4ms/pcb-SCMv3/p5/pcba/Quotation (scmplus-faceplate-v1.0).pdf

Customer:
ATTN: Dan
15th.Jul.2022
P/N: | scmplus-faceplate-v1.0
Layer counts: | 2L
Material: | FR4 1.6mm
Finished copper: | 1oz
Surface finished: | HASL-LF
Unit size: | 60.6*128.5mm
Panel size: | /
Solder Mask color: | Black
Legend color: | White
Min hole size: | 2.92mm
Hole quantity: | 92
Min Track /Gap: | copper
Min space from hole to line | /

Other info:

Notes: | pls confirm the data in red color
Quantity: | | 200pcs
Unit price( USD /PCS): | | $2.18
Tooling charge and Flying test cost : | | $200.00
Freigth cost (USD) : | | /
Total amount(USD): | | $636.00
Delivery time:
1.56sqm
Note:
1. This quotation is based on the above specification. Any change to this specification will alter the price.
2. The lead time is only for production, not including time on engineering queries or shipment
3. We will charge the test cost if the repeat order will not reach our the Min charge.

# Posin Electronics Limited

Address :B-709,Dahong High-tech Park,No.28 Beiting Road Shajing Street,Baoan District, Shenzhen City TEL: +86-755-86372522 FAX:+86-755-86372119 EMAIL:sales3@posinpcb.com

From: Posin Electronics Limited

# Quotation

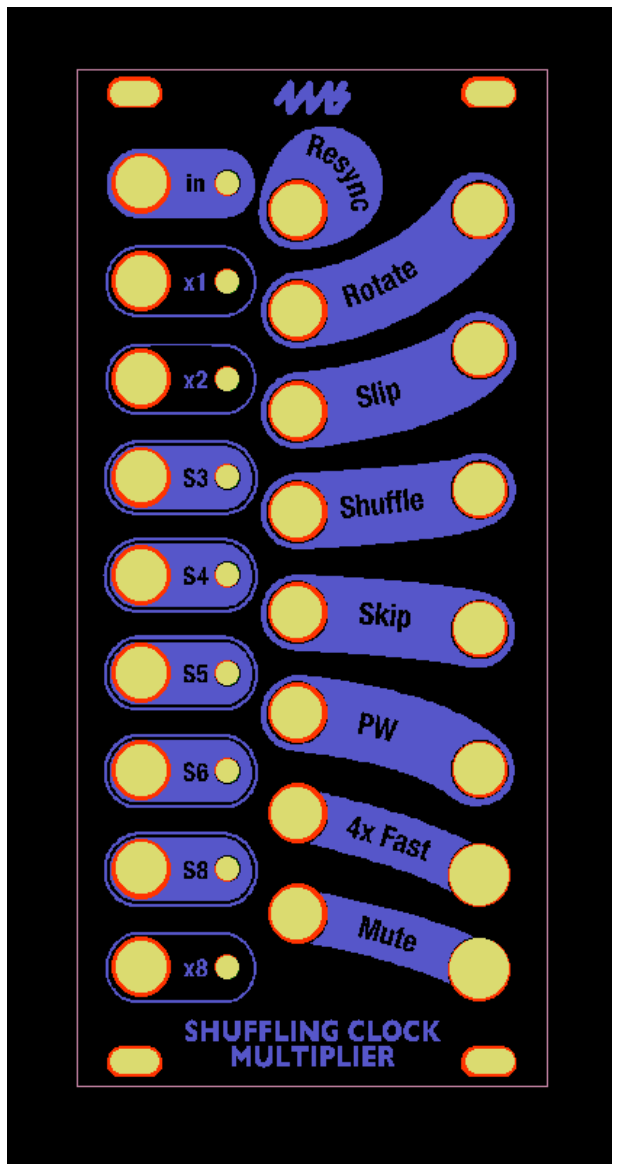
[picture p1: figure]
1.min. 25um copper in PTH
