4ms/pcb-SCMv3/faceplate-p1/artwork sources/2000ppi/silk.png

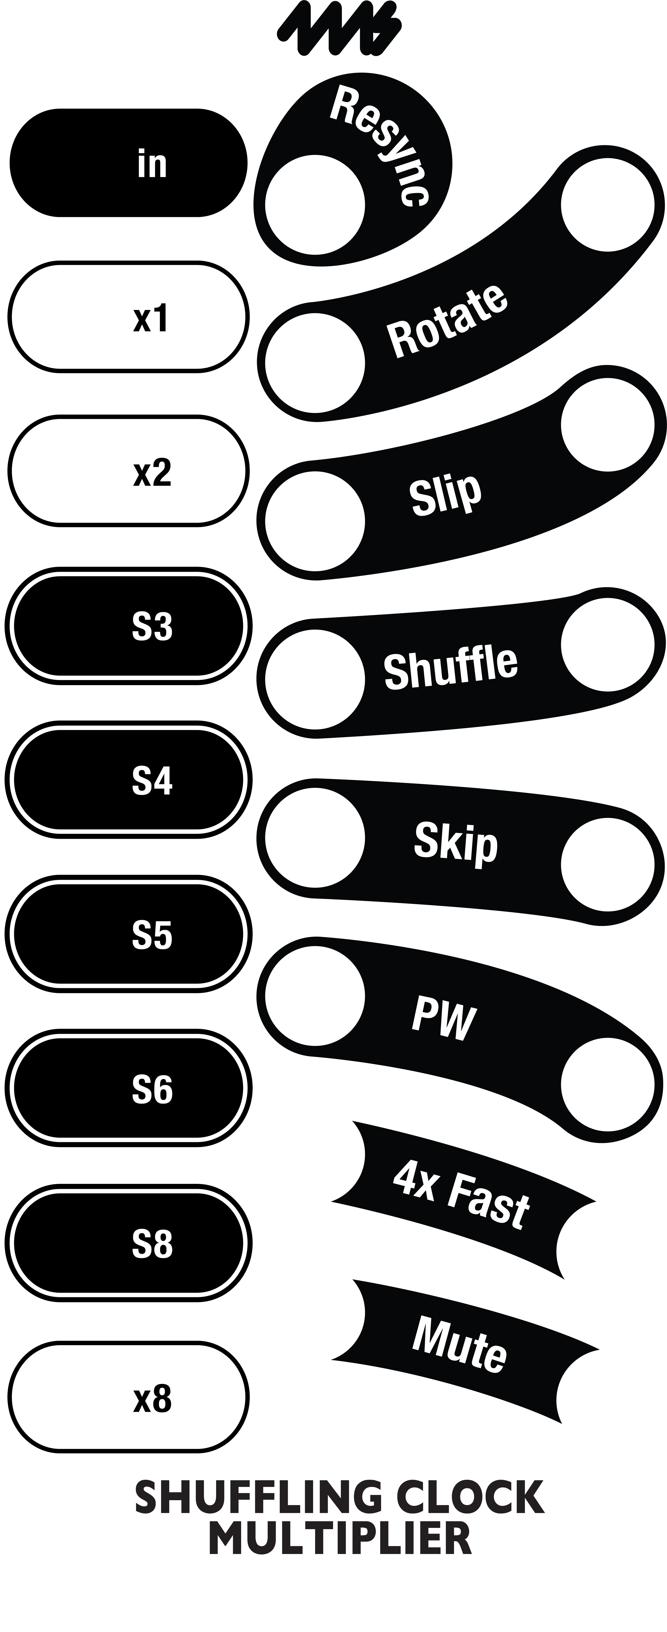
faceplate-p1/artwork sources/2000ppi/silk.png
