4ms/pcb-SCMv3/faceplate-p1/board-lineup.jpg

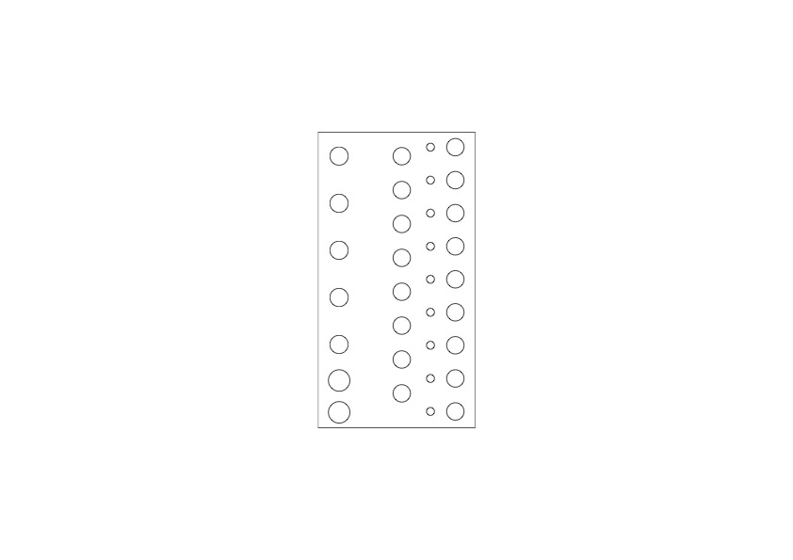
faceplate-p1/board-lineup.jpg
