4ms/pcb-SCMv3/p5/pcba/SCMplus-bom_BX2040396V1-EQ.xlsx

Sheet: EQs
顾客型号(Customer P/N)： |  | scmplus-v1.0 | Posin Electronics Limited
博鑫型号（Posin Lot No）： |  | BX2040396V1
顾客代码(Customer Code)： |  | 204
编写人(Made by)： |  | 刘韶华
联系电话（Telephone） |  | 0755-86372522
编写日期时间(Date&Time)： |  | 2022-07-20 | Address :B-709,Dahong High-tech Park,No.28 Beiting Road Shajing Street,Baoan District, Shenzhen China
博鑫工程师问题列表(EQs from Posin) |  |  |  |  |  | 答复人（Answer by)：
序号 No. | 问题描述 Problem Description |  |  | 博鑫建议 Posin Recommendation | 附件 Attachments | 客户回复 customer's answer
1 | Pls see 1.jpg. Item 16 on the BOM, P/N: RC0603FR-0710KL, desginator: R3, R7, R36. The value of the resistance is 10k, but description column has two vaules 470R and 10k. Pls confirm which value is correct. |  |  |  | 1.jpg | pls reply here | Correct value is 10k
2 | Pls see 2.jpg. Item 21 on the BOM, P/N: RC0603FR-0710KL, desginator R16, R44, R45, R47, R48, R50. The value of the resistance is 10K, but description column has two values 100K and 10K, pls confirm which value is correct. |  |  |  | 2.jpg | pls reply here | Correct value is 10k
3 | Pls see 3.jpg. Item 23 on the BOM, P/N: RC0603FR-0710KL, desginator R22, the value of the resistance is 10K, but the description column has two values 4.7K and 10K. Pls confirm which value is correct. |  |  |  | 3.jpg | pls reply here | Correct value is 10k
4 | Pls see 4,jpg. Item 24 on the BOM, P/N: RC0603FR-0715KL, desginator R30, R37, R39. The value of the resistance is 15K, but the description column has two values 100k and 15K, pls confirm which value is correct. |  |  |  | 4.jpg | pls reply here | Correct value is 15k
5 | Pls see 5.jpg. Item 26 on the BOM, P/N: RC0603FR-0747KL, desginator R40. The value of the resistance is 47K, but the description column shows the value is 470K. Pls confirm which value is correct. |  |  |  | 5.jpg | pls reply here | Correct part number is RC0603FR-07470KL (47k)
6 | Pls see 6.jpg. Item 28 on the BOM, P/N: RC0603FR-071KL, desginator R43, R46, R49. The value of the resistance is 1K, but the description column has tao values 100R and 1K, pls confirm which value is correct. |  |  |  | 6.jpg | pls reply here | Correct value is 1k
7 | Pls see 7.jpg. Item 9 on the BOM, P/N: 1-0601FBV0T, desginator J1. But we didn't find the silk screen J1 on the PCB. Pls mark J1 position on the PCB picture on 7.jpg |  |  |  | 7.jpg | pls reply here | See picture
8 |  |  |  |  | 8.jpg
9 |  |  |  |  | 9.jpg
10 |  |  |  |  | 10.jpg
11 |  |  |  |  | 11.jpg
12 |  |  |  |  | 12.jpg
13 |  |  |  |  | 13.jpg
14 |  |  |  |  | 14.jpg
15 |  |  |  |  | 15.jpg
16 |  |  |  |  | 16.jpg
17 |  |  |  |  | 17.jpg

Sheet: 1.jpg
返回（Return） EQs

Sheet: 2.jpg
返回（Return） EQs

Sheet: 3.jpg
返回（Return） EQs

Sheet: 4.jpg
返回（Return） EQs

Sheet: 5.jpg
返回（Return） EQs

Sheet: 6.jpg
返回（Return） EQs

Sheet: 7.jpg
返回（Return） EQs

Sheet: 8.jpg
返回（Return） EQs

Sheet: 9.jpg
返回（Return） EQs

Sheet: 10.jpg
返回（Return） EQs

Sheet: 11.JPG
返回（Return） EQs

Sheet: 12.jpg
返回（Return） EQs

Sheet: 13.jpg
返回（Return） EQs

Sheet: 14.jpg
返回（Return） EQs

Sheet: 15.jpg
返回（Return） EQs

Sheet: 16.jpg
返回（Return） EQs

Sheet: 17.jpg
返回（Return） EQs
