4ms/pcb-SCMv3/faceplate-p2/SCMv3-B_Silkscreen.pdf

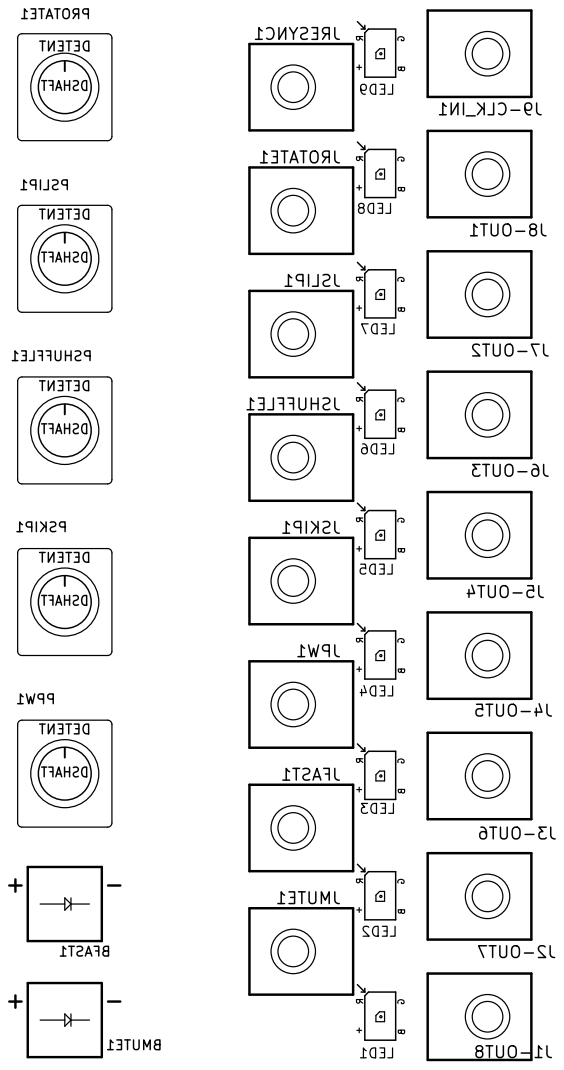
[picture p4: page 1]
