4ms/pcb-SCMv3/faceplate-p1/board-lineup.pdf

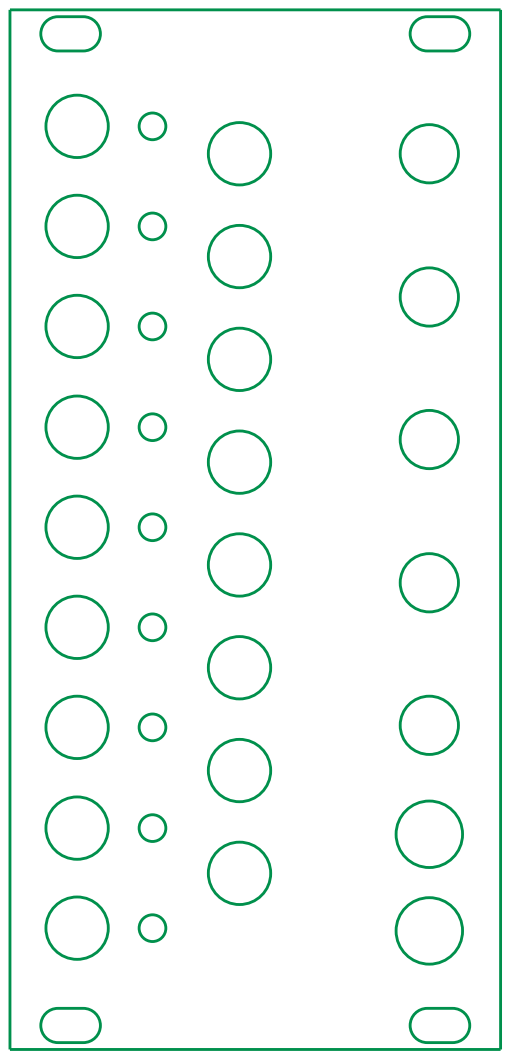
[picture p5: page 1]
