4ms/pcb-SCMv3/faceplate-p1/export.pdf

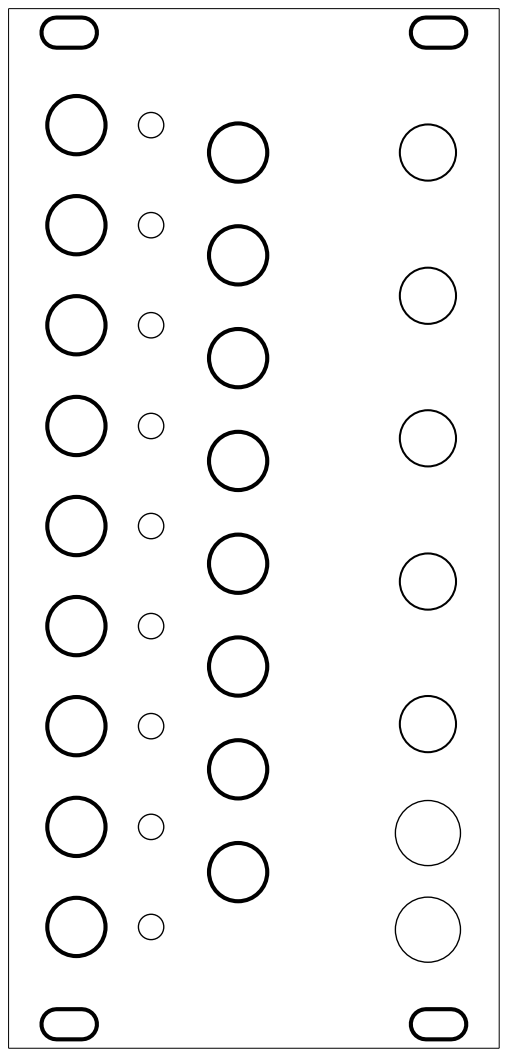
[picture p6: page 1]
