4ms/pcb-SCMv3/p3/cubemx/scmv3-f030k/scmv3-f030k.ioc

Mcu.UserName=STM32F030K6Tx
PA0.Signal=GPIO_Output
PA1.Signal=GPIO_Output
PA12.Signal=GPIO_Input
PA13.Signal=SYS_SWDIO
PA14.Signal=SYS_SWCLK
PA15.Signal=GPIO_Input
PA2.Signal=ADC_IN2
PA3.Signal=ADC_IN3
PA4.Signal=GPIO_Output
PA5.Signal=GPIO_Output
PA6.Signal=GPIO_Output
PA7.Signal=ADC_IN7
PB0.Signal=ADC_IN8
PB1.Signal=ADC_IN9
PB3.Signal=GPIO_Input
PB4.Signal=GPIO_Input
PB5.Signal=GPIO_Output
PB6.Signal=GPIO_Output
PB7.Signal=GPIO_Output
PF0-OSC_IN.Signal=RCC_OSC_IN
PF1-OSC_OUT.Signal=RCC_OSC_OUT
