4ms/pcb-SCMv3/(commit log)

2021-06-21 Initial commit: combined SCM + SCMBO files
    [SCMv3.kicad_pcb, SCMv3.kicad_sch]
2021-06-21 Added original SCM/SCMBO schematics converted to Kicad5.99
    [SCMBO.kicad_sch, clocker-12b.kicad_sch, clocker-12b_1.kicad_sch, clocker-12b_2.kicad_sch]
2021-06-22 combo schematic as of 6/21/21
    [SCMv3.kicad_sch]
2021-06-23 6/21 scm schematic
    [SCMv3.kicad_sch]
2021-06-23 SCMV3 SCHEMATIC 6/21
    [SCMv3.kicad_sch]
2021-06-25 SCM combo schematic 6/24
    [SCMv3.kicad_sch]
2021-06-25 6/25 SCM SCHEM
    [SCMv3.kicad_sch]
2021-06-25 6/25 SCM SCHEMATIC
    [SCMv3.kicad_sch]
2021-06-25 6/25 SCM
    [SCMv3.kicad_sch]
2021-06-28 SCHEM + PCB 6/
    [SCMv3.kicad_pcb, SCMv3.kicad_sch]
2021-06-30 PCB + SCHEM 6/30
    [SCMv3.kicad_pcb, SCMv3.kicad_sch]
2021-07-02 PCB +SCHEM 7/02
    [SCMv3.kicad_pcb, SCMv3.kicad_sch]
2021-07-05 SCM PCB+SCHEM 7/05
    [SCMv3.kicad_pcb]
2021-07-07 Fixes/tweaks to sch+pcb:
    -Changed PCB form 16-layer to 2-layer board.
    -RESET net was attached to +5V, moved it to _RESET/PC6 pin 29 of U1
    -Renamed net UC_IN to UC_LED_IN (it only drives the IN LED, nothing else)
    [SCMv3.kicad_pcb, SCMv3.kicad_sch]
2021-07-07 Moved XTAL caps (C4, C5) GND trace to go directly to uc (U1)
    [SCMv3.kicad_pcb]
2021-07-07 Removed all duplicate Vias. Project ignores silk overlap DRC errors
    [SCMv3.kicad_pcb]
2021-08-14 Added faceplate
    [SCMv3-faceplate-B_Cu.gbl, SCMv3-faceplate-B_Mask.gbs, SCMv3-faceplate-Edge_Cuts.gm1, SCMv3-faceplate-F_Cu.gtl, SCMv3-faceplate-F_Mask.gts, SCMv3-faceplate-F_Silkscreen.gto, SCMv3-faceplate-drl_map.gbr, SCMv3-faceplate-job.gbrjob]
2021-08-16 SCM v3 updates
    *added missing trace for buttons
    *moved trip pot
    *flipped pots around
    *removed C18 and 21
    [JLCPCB parts actually used bom.xls, SCMv3-BOM.csv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]
2021-08-18 replaced 9v reg with 8v reg
    [SCMv3.kicad_pcb, SCMv3.kicad_sch]
2021-10-12 nudged leds
    [SCMv3.kicad_pcb]
2021-10-12 Rerouting after nudging leds
    ran DRC, no violations nor warnings
    [SCMv3.kicad_pcb]
2021-10-12 renamed faceplate to faceplate-p1, and created faceplate-p2
    [SCMv3-faceplate-B_Cu.gbl, SCMv3-faceplate-B_Mask.gbs, SCMv3-faceplate-Edge_Cuts.gm1, SCMv3-faceplate-F_Cu.gtl, SCMv3-faceplate-F_Mask.gts, SCMv3-faceplate-F_Silkscreen.gto, SCMv3-faceplate-drl_map.gbr, SCMv3-faceplate-job.gbrjob]
2021-10-12 p2: Added text to Fsilk and exported gerbers
    [SCMv3-B_Cu.gbl, SCMv3-B_Mask.gbs, SCMv3-B_Paste.gbp, SCMv3-B_Silkscreen.gbo, SCMv3-Edge_Cuts.gm1, SCMv3-F_Cu.gtl, SCMv3-F_Mask.gts, SCMv3-F_Paste.gtp]
2021-10-12 Exported gerbers for faceplate-p2
    [SCMv3-faceplate-B_Cu.gbl, SCMv3-faceplate-B_Mask.gbs, SCMv3-faceplate-F_Cu.gtl, SCMv3-faceplate-F_Mask.gts, SCMv3-faceplate-F_Silkscreen.gto, SCMv3-faceplate-drl_map.gbr, SCMv3-faceplate-p2-B_Cu.gbl, SCMv3-faceplate-p2-B_Mask.gbs]
2021-10-29 SCMBOV3 updates
    Updated resistor value to fix blueness of white led
    Changed the pot footprints on schematic and pcb
    Flipped shuffle/skip/pw pots so they are not longer backward on sch and pcb
    sorry if I staged too many things I was not sure...
    [JLCPCB parts actually used bom.xls, SCMv3-BOM.csv, SCMv3-bom-less-cols.csv, SCMv3-jlcpcb-col.csv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]
2021-11-02 added F030 chip (not connected)
    [SCMv3.kicad_sch]
2021-11-11 created p3 (ARM version)
    [SCMv3-B_Cu.gbl, SCMv3-B_Mask.gbs, SCMv3-B_Paste.gbp, SCMv3-B_Silkscreen.gbo, SCMv3-Edge_Cuts.gm1, SCMv3-F_Cu.gtl, SCMv3-F_Mask.gts, SCMv3-F_Paste.gtp]
2021-11-11 Restored p2
    [SCMv3.kicad_sch]
2021-11-11 Removed extra copies of pcb, and gerbers for p3
    [SCMv3-B_Cu.gbl, SCMv3-B_Mask.gbs, SCMv3-B_Paste.gbp, SCMv3-B_Silkscreen.gbo, SCMv3-Edge_Cuts.gm1, SCMv3-F_Cu.gtl, SCMv3-F_Mask.gts, SCMv3-F_Paste.gtp]
2021-11-11 p3 ready to connect pins: then route
    [SCMv3.kicad_pcb, SCMv3.kicad_sch]
2021-11-11 Atmega replacement and other mods
    [SCMv3.kicad_pcb, SCMv3.kicad_sch]
2021-11-16 Notes on schematic about wrong pin assignments. Cleaned up schematic, too
    To Do:
    Sch: Some nets requiring an ADC pin are connected to non-ADC pins.
    PCB: Fix routing to pots with V+/GND swapped on pins 1/3. Also fix routing to ADC pins
    Done:
    Removed R16 (RESET->V+) and replaced with C24 (RESET->GND).
    Connected BOOT0 to GND.
    Flipped V+/GND on three pots that were backwards on last proto (fixed on schematic only)
    [SCMv3.kicad_pcb, SCMv3.kicad_sch]
2021-11-16 Fixed errors in pcb and updated schematic accordingly
    [SCMv3.kicad_pcb, SCMv3.kicad_sch]
2021-11-16 Fixed errors on pcb and schem
    [SCMv3.kicad_pcb, SCMv3.kicad_sch]
2021-11-16 Organized silk
    [SCMv3.kicad_pcb]
2021-12-02 Silk cleanup
    [SCMv3.kicad_pcb]
2022-03-29 saved schematic with kicad 6.0.4
    [SCMv3.kicad_sch]
2022-03-29 fixed routing error
    [SCMv3.kicad_pcb, SCMv3.kicad_sch]
2022-03-29 fixed schematic: swd pins swapped with clk in pin
    [SCMv3.kicad_pcb, SCMv3.kicad_sch]
2022-03-29 Applied routing changes to p4 PCB
    [SCMv3.kicad_pcb]
2022-03-29 Revert "Merge remote-tracking branch 'origin/main' into main"
    This reverts commit 63f0bb0c0b25969e804c40226811b6ef72d39a13.
    [SCMv3.kicad_pcb, SCMv3.kicad_sch]
2022-04-04 changed +5V net over to +3.3VA
    [SCMv3.kicad_pcb, SCMv3.kicad_sch]
2022-04-15 updated p4 schematic to use level shifters instead of hex inverters
    [SCMv3.kicad_sch]
2022-05-04 WIP updating p4
    [SCMv3.kicad_pcb, SCMv3.kicad_sch]
2022-05-04 Finished schematic for SCMplus p4. Renamed to "SCMplus"
    [SCMplus.kicad_pcb, SCMplus.kicad_sch]
2022-05-04 Ready for p4 layout
    [SCMplus.kicad_pcb, SCMplus.kicad_sch]
2022-05-09 Updated symbol for 100R resistor from library
    [SCMplus.kicad_sch]
2022-05-12 layout ip
    [SCMplus.kicad_pcb, SCMplus.kicad_sch]
2022-05-12 layout done
    routing and silk are complete. DRC has been run. ready for review.
    [SCMplus.kicad_pcb]
2022-05-13 fixed VR1 error
    [SCMplus.kicad_pcb, SCMplus.kicad_sch]
2022-05-16 Tweaked layout, finalized.
    [SCMplus.kicad_pcb]
2022-05-16 Exported gerbers, pos file, BOM for jlcpcb. Ready to order
    [SCMplus-B_Cu.gbl, SCMplus-B_Mask.gbs, SCMplus-B_Paste.gbp, SCMplus-B_Silkscreen.gbo, SCMplus-Edge_Cuts.gm1, SCMplus-F_Cu.gtl, SCMplus-F_Mask.gts, SCMplus-F_Paste.gtp]
2022-05-17 jlcpcb prep
    [SCMplus-top-pos.csv-jlcpcb.csv]
2022-05-25 Created p5, applied changes to schematic. NOTE: pos files are copied
    from p4, if no components move (only move traces), you can re-use these files.
    The BOM has changed since p4 so we can't re-use that.
    [SCMplus.bom-jlcpcb.csv, SCMplus.kicad_pcb, SCMplus.kicad_sch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]
2022-05-25 slight routing changes to accomodate slight pcb changes.
    routing, DRC, silk.
    [SCMplus.kicad_pcb]
2022-05-25 Updated version, and connected VR1 pin 2B to 3.3V
    [SCMplus.kicad_pcb]
2022-07-15 p5 BOM, gerbers, pos. Submitted for quote from Posin
    [SCMplus-B_Cu.gbl, SCMplus-B_Mask.gbs, SCMplus-B_Paste.gbp, SCMplus-B_Silkscreen.gbo, SCMplus-Edge_Cuts.gm1, SCMplus-F_Cu.gtl, SCMplus-F_Mask.gts, SCMplus-F_Paste.gtp]
2022-07-15 BOM exported. changed..?
    [SCMplus-bom.xlsx]
2022-07-17 BOM cost from Posin
    [SCMplus-bom_(20220715 cost)-response.xlsx, SCMplus-bom_(20220715 cost).xlsx]
2022-07-21 EQ from Posin, fixed many BOM errors on BOM and schematic
    [SCMplus-bom_BX2040396V1-EQ.xlsx, SCMplus.kicad_sch]
2022-07-25 Moved J1 reference on PCB
    [SCMplus.kicad_pcb]
